YYYKblue/Simple-Oscilloscope/SCH_Schematic1_2025-11-06.pdf

最小系统板 | OLED | ENCODER | 温湿度传感器

# KEY_FFT

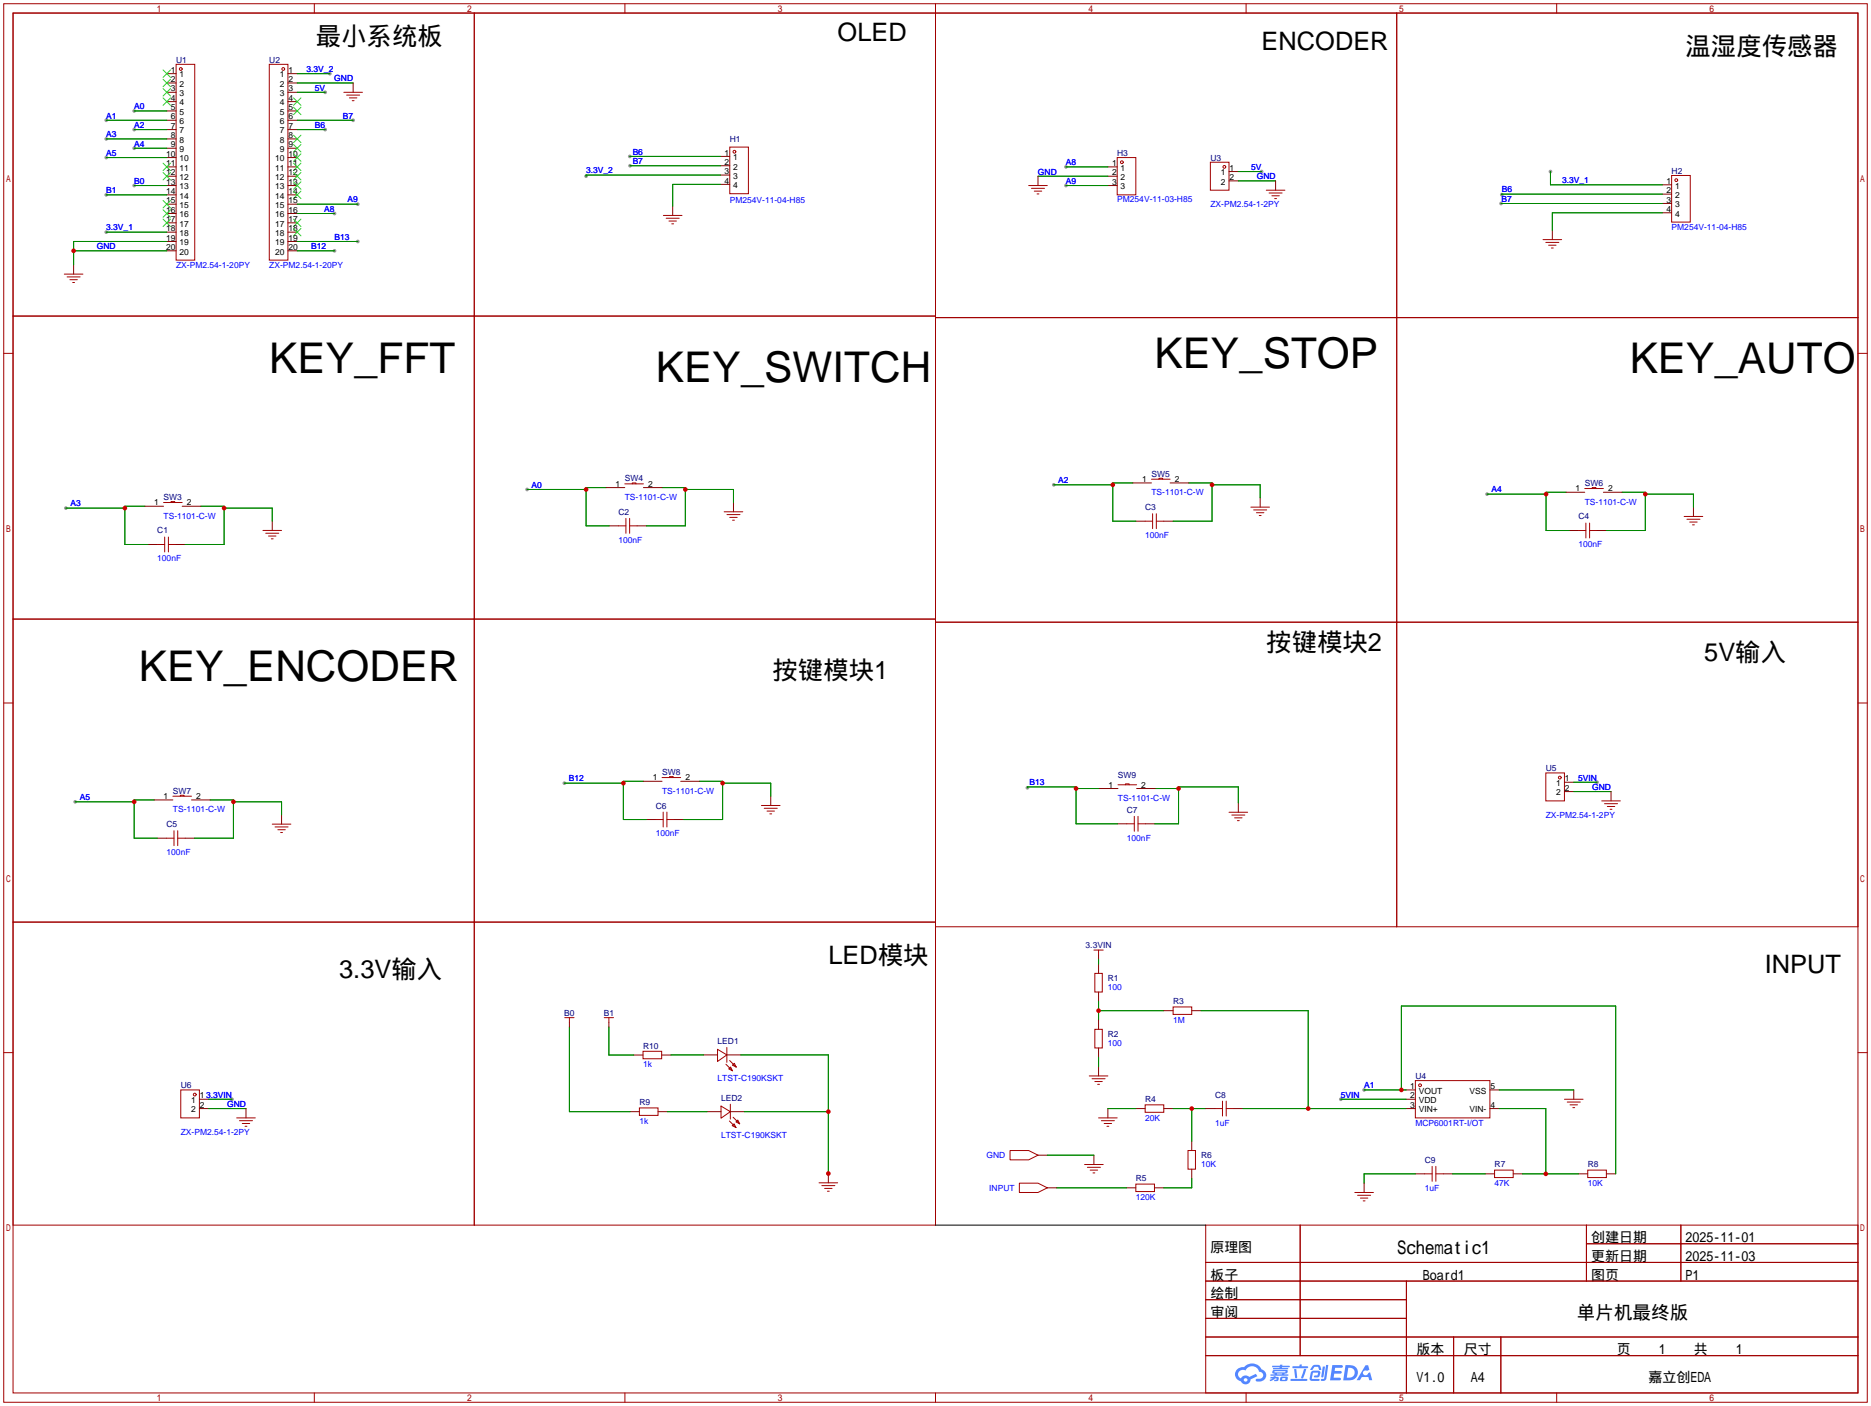
[picture p1: page 1]

3.3V输入 U6 3.3VIN 1 1 2 GND ZX-PM2.54-1-2PY | B0 | B1 | LED模块

原理图 | Schematic1 | 创建日期 | 2025-11-01

更新日期 | 2025-11-03

板子 | Board1 | 图页 | P1
绘制 | | 单片机最终版
审阅

V1.0 | A4 | 嘉立创EDA
