YYYKblue/Simple-Oscilloscope/Core/Inc/main.h

#define led_b0_Pin GPIO_PIN_0
#define led_b0_GPIO_Port GPIOB
#define led_b1_Pin GPIO_PIN_1
#define led_b1_GPIO_Port GPIOB
#define oled_key_up_Pin GPIO_PIN_12
#define oled_key_up_GPIO_Port GPIOB
#define oled_key_up_EXTI_IRQn EXTI15_10_IRQn
#define oled_key_down_Pin GPIO_PIN_13
#define oled_key_down_GPIO_Port GPIOB
#define oled_key_down_EXTI_IRQn EXTI15_10_IRQn
#define OLED_SDA_Pin GPIO_PIN_6
#define OLED_SDA_GPIO_Port GPIOB
#define OLED_SCL_Pin GPIO_PIN_7
#define OLED_SCL_GPIO_Port GPIOB
