YYYKblue/Simple-Oscilloscope/Core/Src/main.c

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
/* Includes ------------------------------------------------------------------*/
#include "main.h"
#include "adc.h"
#include "dma.h"
#include "tim.h"
#include "gpio.h"

/* USER CODE BEGIN Includes */
#include <stdio.h>
#include "oled.h"
#include "font.h"
#include "boot_animation.h"
#include "app_main.h"
#include "app_drivers.h"
#include "key_control.h"
#include "aht20.h"

/* USER CODE END Includes */


/* USER CODE BEGIN PV */
//#define ADCDataLength 256
//uint16_t ADCData[ADCDataLength];
char oled_str_buffer[30];
/* USER CODE END PV */

void SystemClock_Config(void);
/* USER CODE BEGIN 0 */
float envtemperature,humidity;
char message1[50];
char message2[20];
/* USER CODE END 0 */

/**
  * @brief  The application entry point.
  * @retval int
  */
int main(void)
{

  /* MCU Configuration--------------------------------------------------------*/

  /* Reset of all peripherals, Initializes the Flash interface and the Systick. */
  HAL_Init();

  /* Configure the system clock */
  SystemClock_Config();

  /* Initialize all configured peripherals */
  MX_GPIO_Init();
  MX_DMA_Init();
  MX_ADC1_Init();
  MX_TIM3_Init();
  MX_TIM1_Init();
  MX_TIM2_Init();
  AHT20_Init();
  /* USER CODE BEGIN 2 */
	//所有初始化全封装在该函数中
  App_Main_Init();
  /* USER CODE END 2 */

  /* Infinite loop */
  /* USER CODE BEGIN WHILE */
  while (1)
  {
		    OLED_NewFrame();
				if (g_menuState == 0) // 第1页: 目录界面
					{
            OLED_PrintASCIIString(45, 0, "Menu", &afont16x8, OLED_COLOR_NORMAL); 
						OLED_PrintASCIIString(0, 20, "1:temandhum", &afont12x6, OLED_COLOR_NORMAL);
            OLED_PrintASCIIString(0, 34, "2:oscilloscope", &afont12x6, OLED_COLOR_NORMAL);
            OLED_PrintASCIIString(0, 48, "3:author", &afont12x6, OLED_COLOR_NORMAL);
					}
				else if (g_menuState == 1) // 第2页: 温湿度
					{
            AHT20_Read(&envtemperature, &humidity);
            sprintf(message1,"室温 : %.1f ℃ ",envtemperature);
            sprintf(message2,"湿度 : %.1f %% ",humidity);
            OLED_PrintString(0, 17, message1, &swimming16x16, OLED_COLOR_NORMAL);
            OLED_PrintString(0, 37, message2, &swimming16x16, OLED_COLOR_NORMAL);
					}
        else if (g_menuState == 2) // 第3页: 示波器
					{
						App_Main_Loop();
					}
        else if (g_menuState == 3) // 第4页: 作者
					{
            OLED_PrintASCIIString(20, 0, "Author", &afont24x12, OLED_COLOR_NORMAL);
            OLED_PrintASCIIString(20, 28, "code by zx", &afont16x8, OLED_COLOR_NORMAL);
            OLED_PrintASCIIString(20, 48, "pcb by sj", &afont16x8, OLED_COLOR_NORMAL);
					}
		
				OLED_ShowFrame();
		
				HAL_Delay(10);
    /* USER CODE END WHILE */

    /* USER CODE BEGIN 3 */
  }
  /* USER CODE END 3 */
}

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
